California-Strawberry-Commission/oas-data-logger-hardware/PCB Rev1/Data Logger Rev1-12V_5V BUCK.dxf

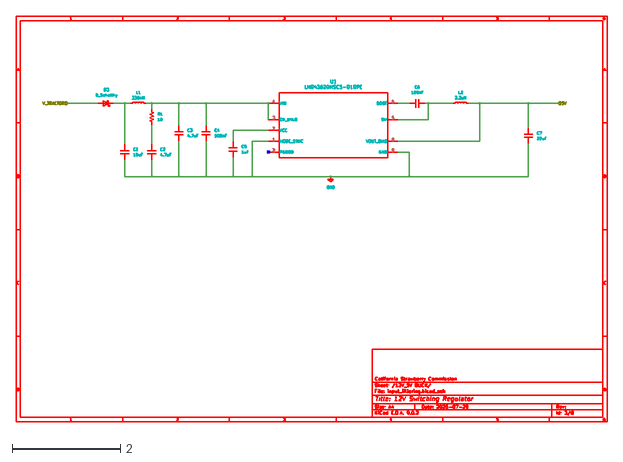
[picture p1: CAD file, 2025-11-17, an earlier design]
PCB Rev1/Data Logger Rev1-12V_5V BUCK.dxf
10.9 x 7.48
