California-Strawberry-Commission/oas-data-logger-hardware/PCB Rev1/Data Logger Rev1-5V_3.3V LDO.dxf

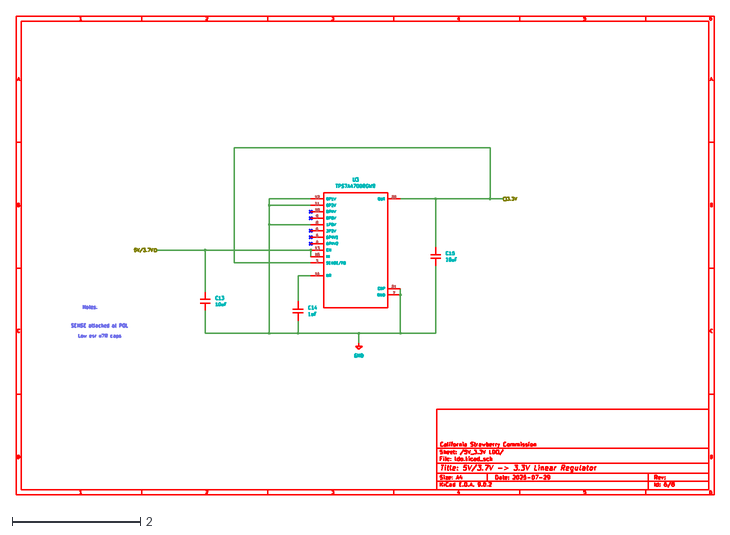
[picture p3: CAD file, 2025-11-17, an earlier design]
PCB Rev1/Data Logger Rev1-5V_3.3V LDO.dxf
10.9 x 7.48
