California-Strawberry-Commission/oas-data-logger-hardware/PCB Rev1/Schematic Drawings/Data Logger Rev1-LOAD_SHARING_&_BAT_CHRG.dxf

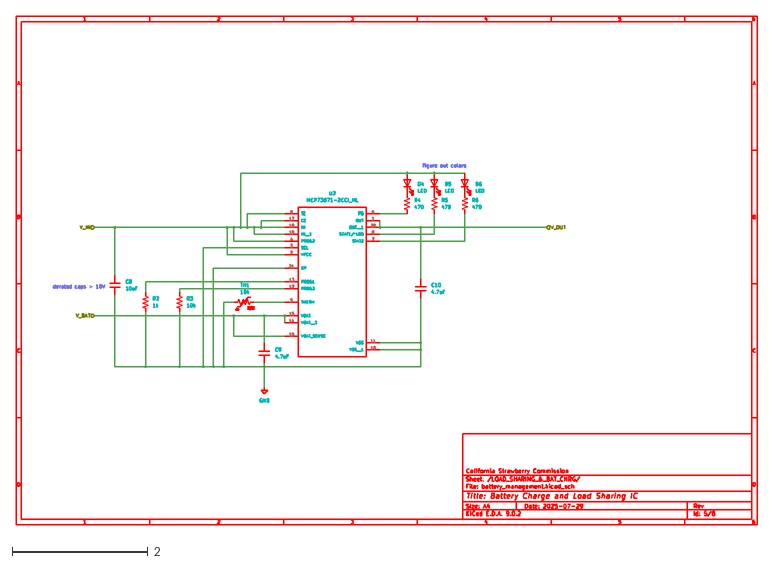
[picture p5: CAD file, 2025-11-17, an earlier design]
PCB Rev1/Schematic Drawings/Data Logger Rev1-LOAD_SHARING_&_BAT_CHRG.dxf
10.9 x 7.48
