California-Strawberry-Commission/oas-data-logger-hardware/PCB Rev1/Schematic Drawings/Data Logger Rev1.dxf

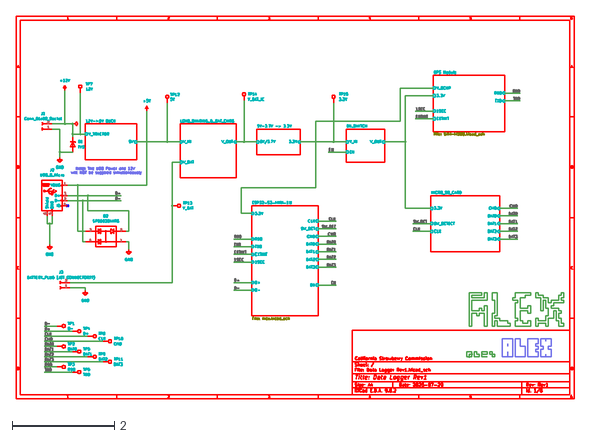
[picture p6: CAD file, 2025-11-17, an earlier design]
PCB Rev1/Schematic Drawings/Data Logger Rev1.dxf
10.9 x 7.48
