California-Strawberry-Commission/oas-data-logger-hardware/(commit log)

2025-07-01 Initial commit of all current files
    [Data Logger Rev1.kicad_pcb, Data Logger Rev1.kicad_sch, input_filtering.kicad_sch, untitled.kicad_sch]
2025-07-01 Added power filtering stage 1, DC->DC Buck
    [Data Logger Rev1.kicad_pcb, Data Logger Rev1.kicad_sch, input_filtering.kicad_sch, untitled.kicad_sch]
2025-07-01 Added DC->DC Buck, schematic only
2025-07-11 Starting work on power tree, introduced power mux
    [Data Logger Rev1.kicad_sch, input_filtering.kicad_sch, untitled.kicad_sch]
2025-07-11 Progress marches on.
    [Data Logger Rev1.kicad_sch, input_filtering.kicad_sch]
2025-07-14 aggregated SD card and switch, updated power architecture to use 5V, added TVS diode array
    [Data Logger Rev1.kicad_pcb, Data Logger Rev1.kicad_sch, GPS_Module.kicad_sch, input_filtering.kicad_sch, sd_card.kicad_sch]
2025-07-14 small changes
    [Data Logger Rev1.kicad_sch, sd_card.kicad_sch]
2025-07-16 hey now, over under 5 more hours of work?
    [Data Logger Rev1.kicad_sch, GPS_Module.kicad_sch, input_filtering.kicad_sch, sd_card.kicad_sch]
2025-07-30 added new files and switches, notes,tps
    [AP22653Q.kicad_sch, Data Logger Rev1.kicad_sch, battery_management.kicad_sch, input_filtering.kicad_sch, ldo.kicad_sch, mcu.kicad_sch]
2025-07-31 rev 2 schematic with minor changes, final send out before layout
    [AP22653Q.kicad_sch, Data Logger Rev1.kicad_sch, SAM-M10Q.kicad_sch, battery_management.kicad_sch, input_filtering.kicad_sch, ldo.kicad_sch, mcu.kicad_sch, sd_card.kicad_sch]
2025-11-17 added PCB rev2!
    [AP22653Q.kicad_sch, Data Logger Rev1-12V_5V BUCK.dxf, Data Logger Rev1-5V_3.3V LDO.dxf, Data Logger Rev1-EN_SWITCH.dxf, Data Logger Rev1-ESP32-S3-MINI-1U.dxf, Data Logger Rev1-GPS Module.dxf, Data Logger Rev1-LOAD_SHARING_&_BAT_CHRG.dxf, Data Logger Rev1-MICRO_SD_CARD.dxf]
2025-11-17 added components to board outline, Fixed silk
    [PCB Rev2.kicad_pcb]
2025-11-21 power train routed, going to add new GPS module
    [PCB Rev2.kicad_pcb]
2026-01-08 close to final, added PG pin
    [PCB Rev2.kicad_pcb, PCB Rev2.kicad_sch, battery_management.kicad_sch, input_filtering.kicad_sch, mcu.kicad_sch]
2026-05-06 Rev2 schematic/layout updates + Rev1 assets for full dev portability
    Add custom KiCad symbol libs (Snapeda, TestPoint, greyscale_strawb),
    footprints, DXF exports, Gerbers, schematic drawings, and Rev3 datasheet
    draft. Update all Rev2 sub-schematics and PCB layout.
    [AP22653Q.kicad_sch, Data Logger Rev1-12V_5V BUCK.dxf, Data Logger Rev1-5V_3.3V LDO.dxf, Data Logger Rev1-EN_SWITCH.dxf, Data Logger Rev1-ESP32-S3-MINI-1U.dxf, Data Logger Rev1-GPS Module.dxf, Data Logger Rev1-LOAD_SHARING_&_BAT_CHRG.dxf, Data Logger Rev1-MICRO_SD_CARD.dxf]
